scortua/DIIN_PROJECT/README.md

# Proyecto CNC para Cuidado de Plantulas en Vivero

Este proyecto consiste en desarrollar una máquina CNC capaz de cuidar plantulas en un vivero, utilizando motores, materiales reciclables y económicos, incorporando inteligencia artificial y sensores.

## Objetivos
- Automatizar tareas de cuidado en el vivero.
- Optimizar el uso de recursos utilizando materiales reciclables y de bajo costo.
- Integrar sensores para monitorear las condiciones ambientales y de crecimiento de las plantulas.
- Utilizar técnicas de IA para la toma de decisiones en tiempo real.

## Componentes Principales

### Hardware
- **Motores y actuadores:** Responsables del movimiento y la acción precisa en el cuidado de las plantulas.
- **Sensores:** 
    - Sensores de humedad y temperatura para medir las condiciones ambientales.
    - Sensores de luz para asegurar niveles adecuados de iluminación.
- **Materiales reciclables:** Estructuras y componentes fabricados con materiales reutilizados y económicos.
    
### Software
- **Control CNC:** Algoritmos para la operación y movimiento controlado de la máquina.
- **Inteligencia Artificial:** 
    - Procesamiento de datos de sensores.
    - Toma de decisiones automáticas para mejorar el crecimiento de las plantulas.
- **Interfaz de usuario:** Herramienta para monitorear y configurar el sistema en tiempo real.

## Funcionamiento del Sistema

1. **Monitoreo:**  
     Los sensores recogen datos sobre humedad, temperatura y luz.  
2. **Análisis:**  
     La IA analiza la información recopilada para identificar las necesidades de cada plantula.
3. **Acción:**  
     El CNC ejecuta movimientos precisos para crear condiciones óptimas: ajustar la dosificación de agua, mover elementos o modificar la iluminación.
4. **Retroalimentación:**  
     El sistema ajusta sus acciones de forma continua, basándose en los datos en tiempo real.

## Beneficios
- Fomenta el uso de tecnologías sostenibles.
- Aumenta la eficiencia en el cuidado de plantulas.
- Reduce costos mediante el uso de materiales reciclables y componentes económicos.
- Optimiza el crecimiento y la salud de las plantas a través de decisiones basadas en datos.

Este proyecto representa un avance significativo en la integración de la robótica y la inteligencia artificial en la agricultura, proporcionando soluciones innovadoras y sostenibles para el cuidado de viveros.
