scortua/DIIN_PROJECT/Schematic - PCBs/README.md

# Proyecto DIIN
 En este repositorio se encontrara los esquematicos, diseño de PCB's,  programas, etc; sobre el proyecto de CNC que cuide plantulas.
