scortua/DIIN_PROJECT/Images/CNC_DIIN.png

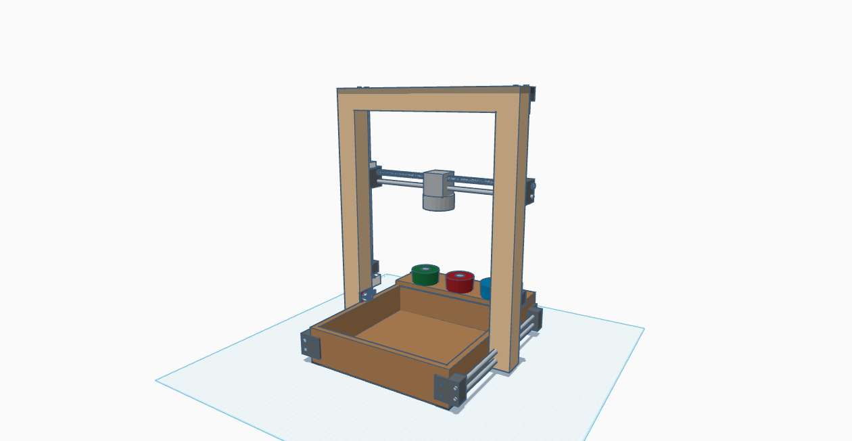
Images/CNC_DIIN.png
