scortua/DIIN_PROJECT/Documents/Box source design/caja_coutois.stl

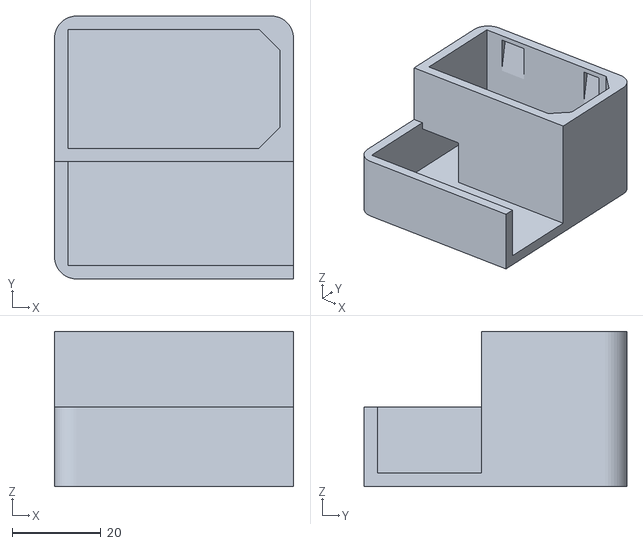
[picture p29: CAD file, 2025-03-30]
Documents/Box source design/caja_coutois.stl
54.0 x 59.3 x 35.0
