scortua/DIIN_PROJECT/(list of files, drawings)

Other design files:
Schematic - PCBs/simulaciones/Project Backups/simulaciones [20250322, 15-41-46].pdsprj
Schematic - PCBs/simulaciones/Project Backups/simulaciones [20250322, 18-07-57].pdsprj
Schematic - PCBs/simulaciones/Project Backups/simulaciones [20250322, 18-07-58].pdsprj
Schematic - PCBs/simulaciones/Project Backups/simulaciones [20250322, 18-08-02].pdsprj
Schematic - PCBs/simulaciones/Project Backups/simulaciones [20250322, 20-23-48].pdsprj
Schematic - PCBs/simulaciones/Project Backups/simulaciones [20250322, 20-23-49].pdsprj
Schematic - PCBs/simulaciones/Project Backups/simulaciones [20250324, 18-50-58].pdsprj
Schematic - PCBs/simulaciones/Project Backups/simulaciones [20250324, 18-50-59].pdsprj
Schematic - PCBs/simulaciones/simulaciones.pdsprj
