scortua/DIIN_PROJECT/Schematic - PCBs/DIIN-proyecto.kicad_pcb

## KiCad design Schematic - PCBs/DIIN-proyecto.kicad_pcb (2025-03-30)

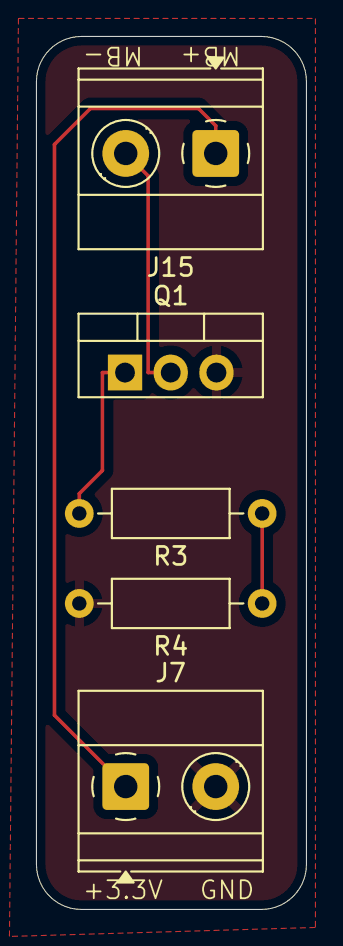
[picture p30: board Schematic - PCBs/DIIN-proyecto.kicad_pcb from above]

Board: 2 copper layers, 15.0 x 48.5 mm, 5 parts (0 on the bottom side), 5 nets.

Parts:
J7, J15: Screw_Terminal_01x02; TerminalBlock_Phoenix_MKDS-1,5-2_1x02_P5.00mm_Horizontal
Q1: IRF540N; TO-220-3_Vertical
R3, R4: 5.1k; R_Axial_DIN0207_L6.3mm_D2.5mm_P10.16mm_Horizontal

Connections:
+3.3V: J7.1, J15.1
GND: J7.2, Q1.3 (S), R4.2
MB-: J15.2, Q1.2 (D)
MBE: R3.1, R4.1
unnamed: Q1.1 (G), R3.2
