scortua/DIIN_PROJECT/Schematic - PCBs/Gerber/camara/camara.kicad_pcb

## KiCad design Schematic - PCBs/Gerber/camara/camara.kicad_pcb (2025-03-30)

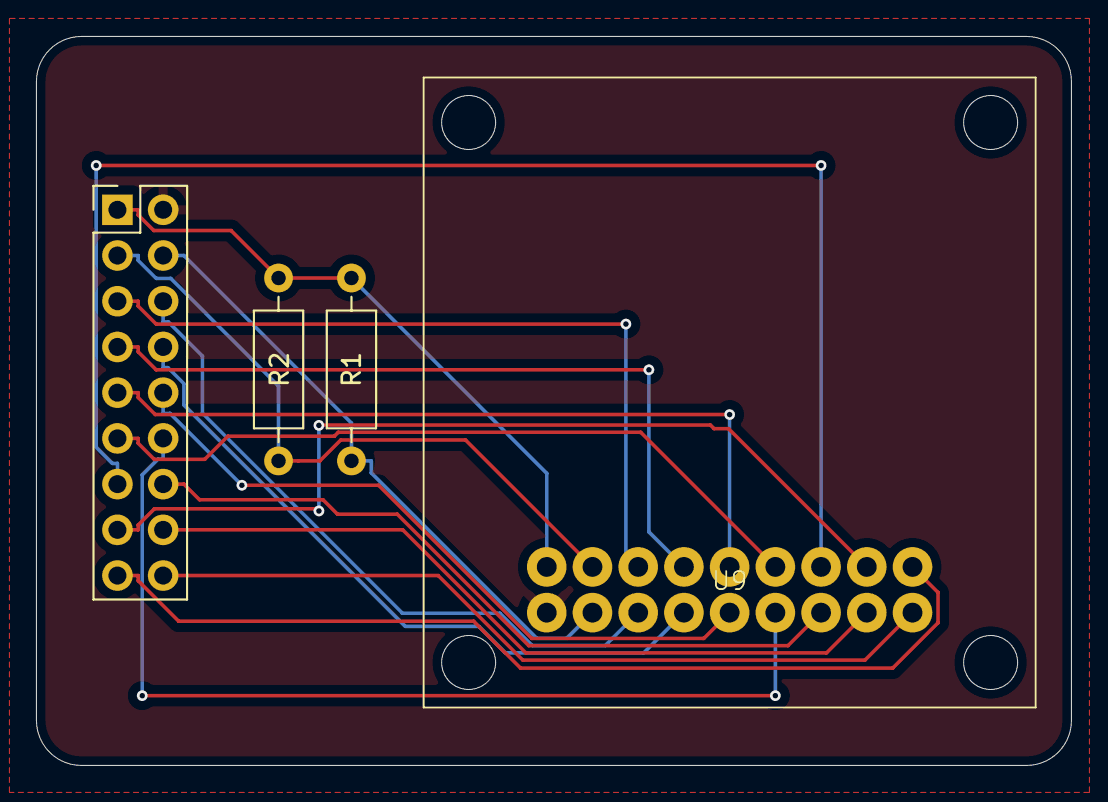
[picture p31: board camara.kicad_pcb from above]

Board: 2 copper layers, 57.5 x 40.5 mm, 4 parts (0 on the bottom side), 18 nets.

Parts:
J1: Conn_02x09_Odd_Even; PinHeader_2x09_P2.54mm_Vertical
R1, R2: 4.7k; R_Axial_DIN0207_L6.3mm_D2.5mm_P10.16mm_Horizontal
U9: OV7670

Connections:
+3.3V: J1.1, R1.1, R2.1, U9.1 (+3.3V)
D0: J1.16, U9.16 (D0)
D1: J1.15, U9.15 (D1)
D2: J1.14, U9.14 (D2)
D3: J1.13, U9.13 (D3)
D4: J1.12, U9.12 (D4)
D5: J1.11, U9.11 (D5)
D6: J1.10, U9.10 (D6)
D7: J1.9, U9.9 (D7)
GND: J1.2, U9.2 (GND)
HREF: J1.6, U9.6 (HREF)
PCLK: J1.7, U9.7 (PCLK)
PWDN: J1.18, U9.18 (PWDN)
RESET: J1.17, U9.17 (RESET)
SOIC: J1.3, R2.2, U9.3 (SOIC)
SOID: J1.4, R1.2, U9.4 (SOID)
VSYNC: J1.5, U9.5 (VSYNC)
XCLK: J1.8, U9.8 (XCLK)
