scortua/DIIN_PROJECT/Schematic - PCBs/Gerber/micros/micros.kicad_pcb

## KiCad design Schematic - PCBs/Gerber/micros/micros.kicad_pcb (2025-03-30)

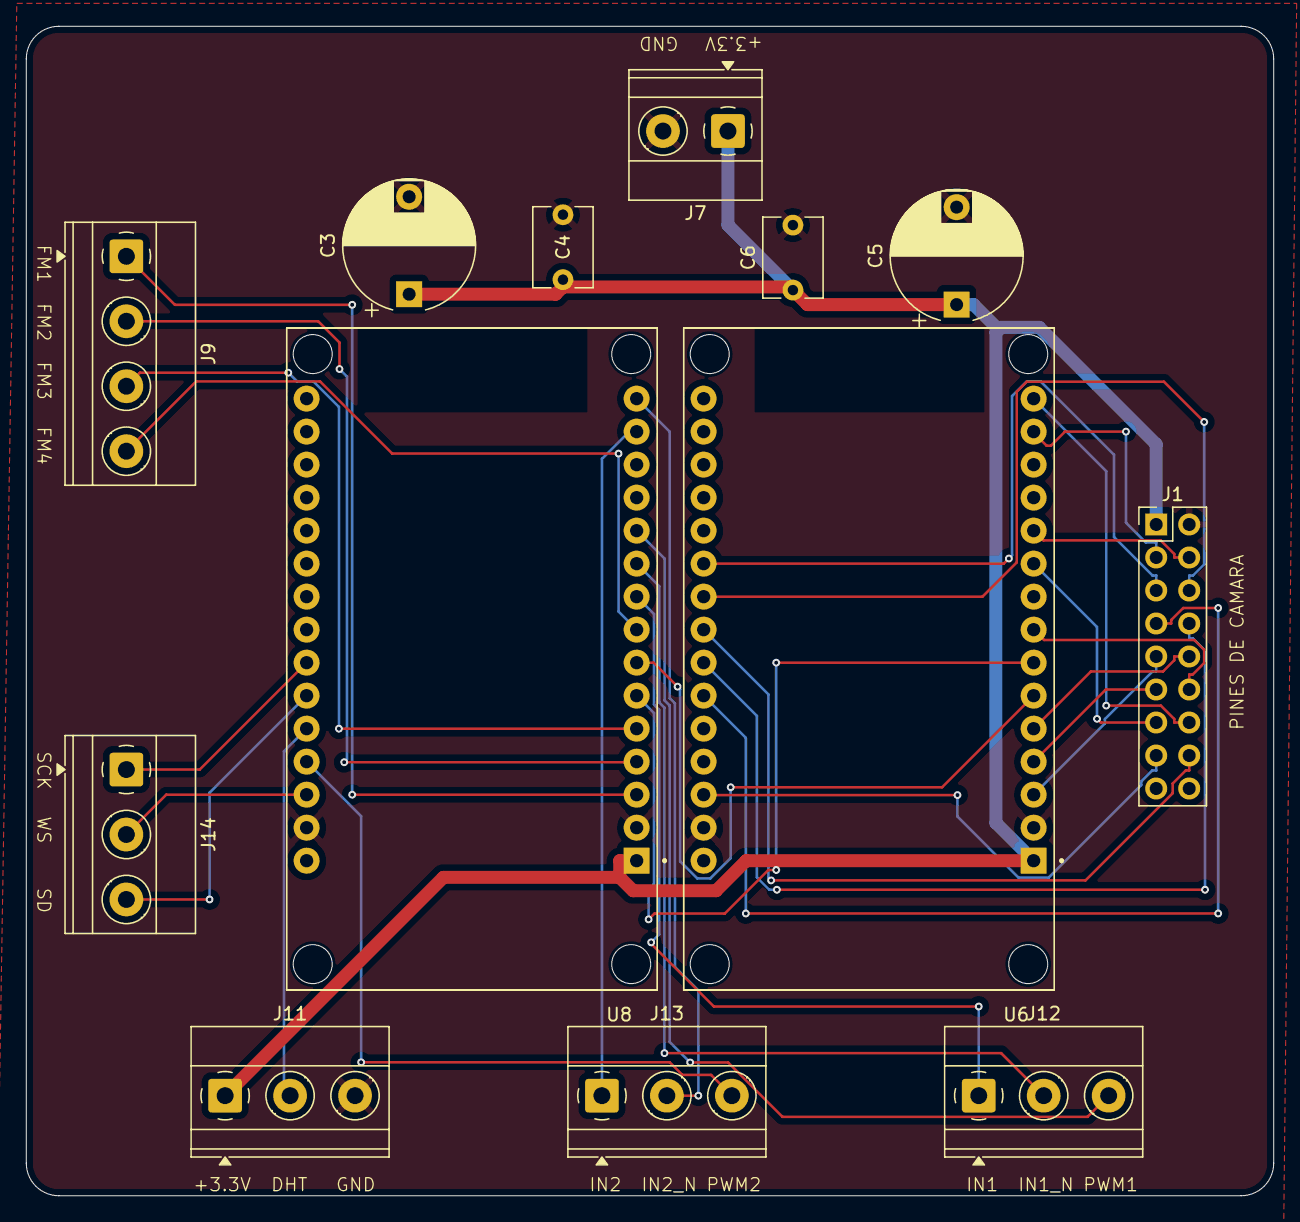
[picture p32: board micros.kicad_pcb from above]

Board: 2 copper layers, 96.0 x 90.0 mm, 13 parts (0 on the bottom side), 32 nets.

Parts:
C3, C5: 10u; CP_Radial_D10.0mm_P7.50mm
C4, C6: 18n; C_Disc_D6.0mm_W4.4mm_P5.00mm
J1: Conn_02x09_Odd_Even; PinHeader_2x09_P2.54mm_Vertical
J7: Screw_Terminal_01x02; TerminalBlock_Phoenix_MKDS-1,5-2_1x02_P5.00mm_Horizontal
J9: Screw_Terminal_01x04; TerminalBlock_Phoenix_MKDS-1,5-4_1x04_P5.00mm_Horizontal
J11, J12, J13, J14: Screw_Terminal_01x03; TerminalBlock_Phoenix_MKDS-1,5-3_1x03_P5.00mm_Horizontal
U6, U8: ESP32-DEVKIT-V1; MODULE_ESP32_DEVKIT_V1

Connections:
+3.3V: C3.1, C4.1, C5.1, C6.1, J1.1, J7.1, J11.1, U6.1 (3V3), U8.1 (3V3)
D0: J1.16, U6.23 (D25)
D1: J1.15, U6.28 (D13)
D2: J1.14, U6.15 (D23)
D3: J1.13, U6.10 (D19)
D4: J1.12, U6.8 (D5)
D5: J1.11, U6.4 (D2)
D6: J1.10, U6.5 (D4)
D7: J1.9, U6.3 (D15)
DHT: J11.2, U8.26 (D14)
FM1: J9.1, U8.3 (D15)
FM2: J9.2, U8.4 (D2)
FM3: J9.3, U8.5 (D4)
FM4: J9.4, U8.8 (D5)
GND: C3.2, C4.2, C5.2, C6.2, J1.2, J7.2, J11.3, U6.2 (GND), U6.29 (GND), U8.2 (GND), U8.29 (GND)
HREF: J1.6, U6.22 (D33)
IN1: J12.1, U8.9 (D18)
IN1_N: J12.2, U8.10 (D19)
IN2: J13.1, U8.14 (D22)
IN2_N: J13.2, U8.15 (D23)
PCLK: J1.7, U6.25 (D27)
PWM1: J12.3, U8.11 (D21)
PWM2: J13.3, U8.27 (D12)
RX: U6.6 (RX2), U8.7 (TX2)
SCK: J14.1, U8.24 (D26)
SD: J14.3, U8.25 (D27)
SOIC: J1.3, U6.14 (D22)
SOID: J1.4, U6.11 (D21)
TX: U6.7 (TX2), U8.6 (RX2)
VSYNC: J1.5, U6.21 (D32)
WS: J14.2, U8.28 (D13)
XCLK: J1.8, U6.24 (D26)
