scortua/DIIN_PROJECT/Schematic - PCBs/Gerber/motores/DIIN-proyecto.kicad_pcb

## KiCad design Schematic - PCBs/Gerber/motores/DIIN-proyecto.kicad_pcb (2025-03-30)

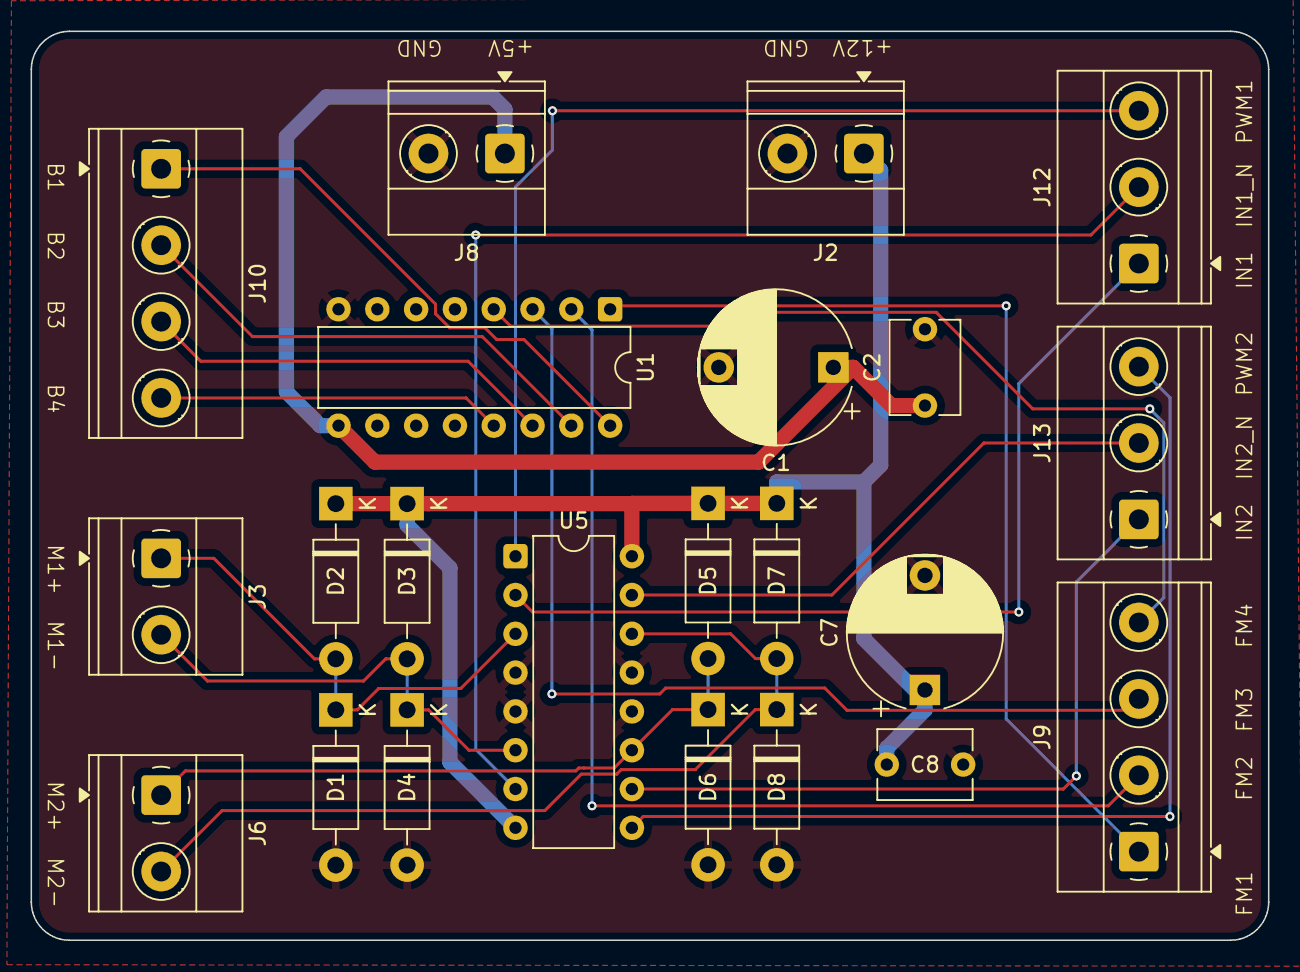
[picture p33: board Schematic - PCBs/Gerber/motores/DIIN-proyecto.kicad_pcb from above]

Board: 2 copper layers, 81.0 x 59.5 mm, 22 parts (0 on the bottom side), 21 nets.

Parts:
C1, C7: 10u; CP_Radial_D10.0mm_P7.50mm
C2, C8: 18n; C_Disc_D6.0mm_W4.4mm_P5.00mm
D1, D2, D3, D4, D5, D6, D7, D8: 1N4004; D_DO-41_SOD81_P10.16mm_Horizontal
J2, J3, J6, J8: Screw_Terminal_01x02; TerminalBlock_Phoenix_MKDS-1,5-2_1x02_P5.00mm_Horizontal
J9, J10: Screw_Terminal_01x04; TerminalBlock_Phoenix_MKDS-1,5-4_1x04_P5.00mm_Horizontal
J12, J13: Screw_Terminal_01x03; TerminalBlock_Phoenix_MKDS-1,5-3_1x03_P5.00mm_Horizontal
U1: ULN2003A; DIP-16_W7.62mm
U5: L293D; DIP-16_W7.62mm

Connections:
+12V: C7.1, C8.1, D2.1 (K), D3.1 (K), D5.1 (K), D7.1 (K), J2.1, U5.8 (VCC2), U5.16 (VCC1)
B1: J10.1, U1.16 (O1)
B2: J10.2, U1.15 (O2)
B3: J10.3, U1.14 (O3)
B4: J10.4, U1.13 (O4)
COM: C1.1, C2.1, J8.1, U1.9 (COM)
FM1: J9.1, U1.1 (I1)
FM2: J9.2, U1.2 (I2)
FM3: J9.3, U1.3 (I3)
FM4: J9.4, U1.4 (I4)
GND: C1.2, C2.2, C7.2, C8.2, D1.2 (A), D4.2 (A), D6.2 (A), D8.2 (A), J2.2, J8.2, U1.8 (GND), U5.4 (GND), U5.5 (GND), U5.12 (GND), U5.13 (GND)
IN1: J12.1, U5.2 (1A)
IN1_N: J12.2, U5.7 (2A)
IN2: J13.1, U5.10 (3A)
IN2_N: J13.2, U5.15 (4A)
PWM1: J12.3, U5.1 (EN1,2)
PWM2: J13.3, U5.9 (EN3,4)
X1: D1.1 (K), D2.2 (A), J3.1, U5.3 (1Y)
X2: D3.2 (A), D4.1 (K), J3.2, U5.6 (2Y)
Y1: D5.2 (A), D6.1 (K), J6.1, U5.11 (3Y)
Y2: D7.2 (A), D8.1 (K), J6.2, U5.14 (4Y)
