scortua/DIIN_PROJECT/Schematic - PCBs/Gerber/fuente/fuente.kicad_pcb

## KiCad design Schematic - PCBs/Gerber/fuente/fuente.kicad_pcb (2025-03-30)

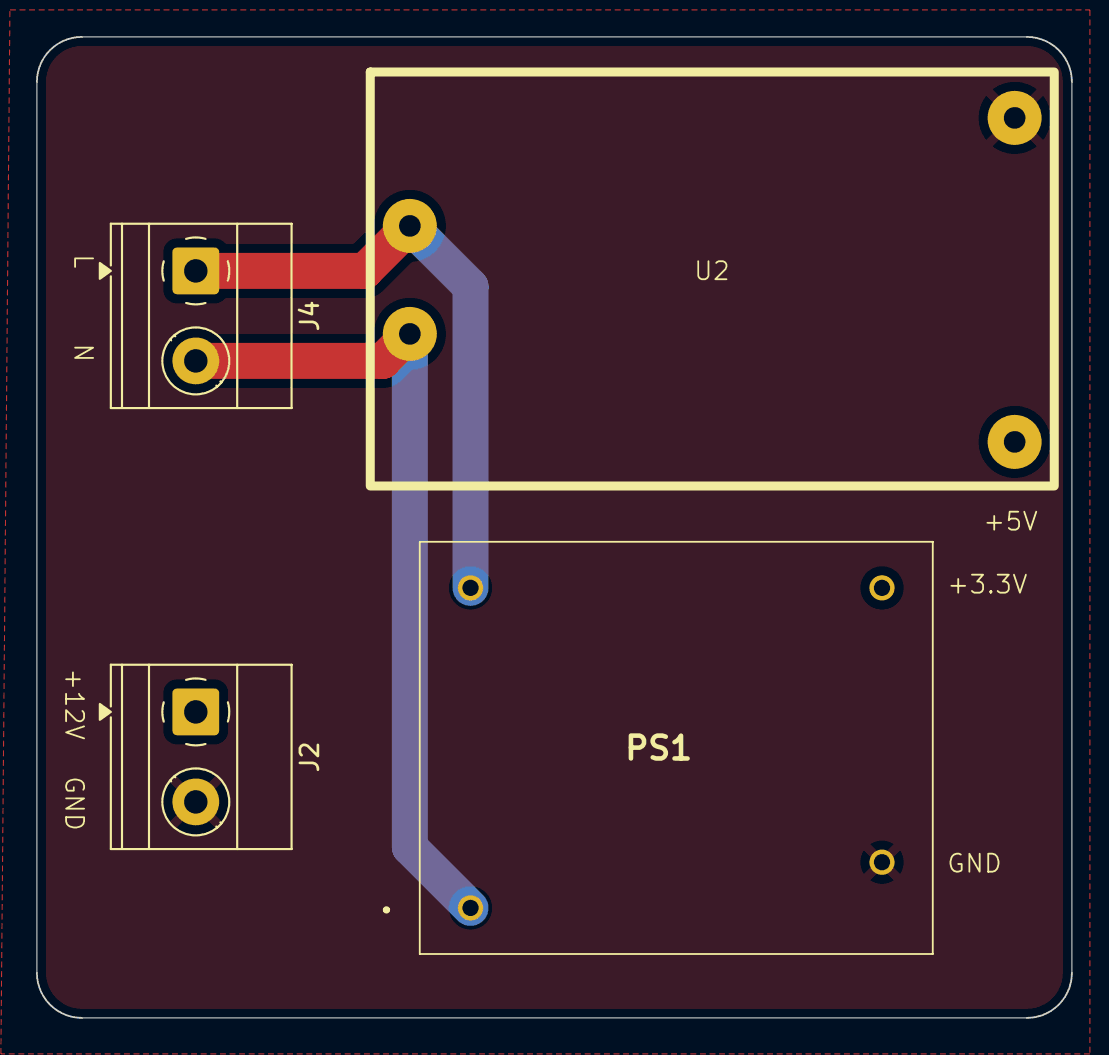
[picture p34: board fuente.kicad_pcb from above]

Board: 2 copper layers, 57.5 x 54.5 mm, 4 parts (0 on the bottom side), 3 nets.

Parts:
J2, J4: Screw_Terminal_01x02; TerminalBlock_Phoenix_MKDS-1,5-2_1x02_P5.00mm_Horizontal
PS1: RAC03-3.3SK; RAC0305SK
U2: HLK-5M03; HLK5M03

Connections:
GND: J2.2, PS1.2 (-VOUT), U2.3 (GND)
L: J4.1, PS1.4 (VAC_IN_(N)), U2.1 (L)
N: J4.2, PS1.1 (VAC_IN_(L)), U2.2 (N)
