scortua/DIIN_PROJECT/Schematic - PCBs/Gerber/microfono/microfono.kicad_pcb

## KiCad design Schematic - PCBs/Gerber/microfono/microfono.kicad_pcb (2025-03-30)

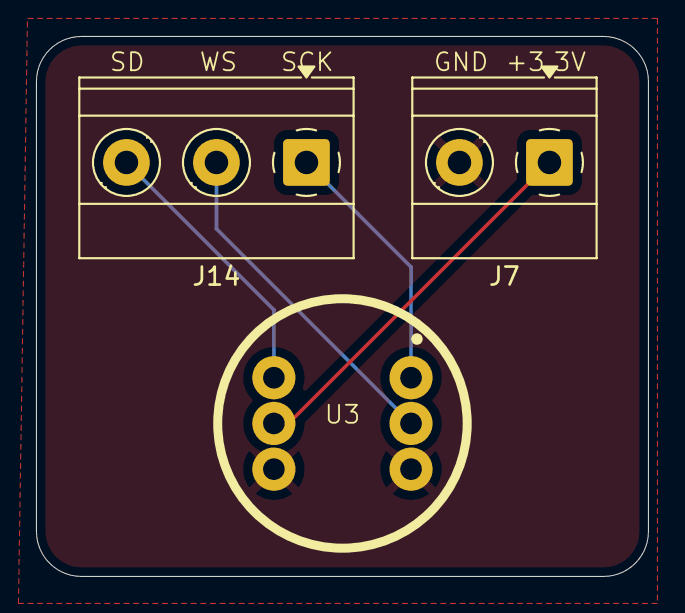
[picture p35: board microfono.kicad_pcb from above]

Board: 2 copper layers, 34.0 x 30.0 mm, 3 parts (0 on the bottom side), 5 nets.

Parts:
J7: Screw_Terminal_01x02; TerminalBlock_Phoenix_MKDS-1,5-2_1x02_P5.00mm_Horizontal
J14: Screw_Terminal_01x03; TerminalBlock_Phoenix_MKDS-1,5-3_1x03_P5.00mm_Horizontal
U3: INMP441

Connections:
+3.3V: J7.1, U3.5 (VDD)
GND: J7.2, U3.3 (L/R), U3.6 (GND)
SCK: J14.1, U3.1 (SCK)
SD: J14.3, U3.4 (SD)
WS: J14.2, U3.2 (WS)
