scortua/DIIN_PROJECT/Code/ESP32_I2S_Camera/ESP32_I2S_Camera_git/XClk.cpp

//parts of his code are taken from
//https://github.com/igrr/esp32-cam-demo
//by Ivan Grokhotkov
//released under Apache License 2.0

//Creación de timer para comunicación I2S

#include "XClk.h"
#include "driver/ledc.h"
#include "Log.h"

bool ClockEnable(int pin, int Hz) {
    periph_module_enable(PERIPH_LEDC_MODULE);

    DEBUG_PRINT("XCLK Frequency Requested: ");
    DEBUG_PRINTLN(Hz);

    ledc_timer_config_t timer_conf;
    timer_conf.bit_num = (ledc_timer_bit_t)1;
    timer_conf.freq_hz = Hz;
    timer_conf.speed_mode = LEDC_HIGH_SPEED_MODE;
    timer_conf.timer_num = LEDC_TIMER_0;
    timer_conf.clk_cfg = LEDC_AUTO_CLK;
    esp_err_t err = ledc_timer_config(&timer_conf);
    if (err != ESP_OK) {
        DEBUG_PRINT("ledc_timer_config error: ");
        DEBUG_PRINTLN(err);
        return false;
    }

    ledc_channel_config_t ch_conf;
    ch_conf.channel = LEDC_CHANNEL_0;
    ch_conf.timer_sel = LEDC_TIMER_0;
    ch_conf.intr_type = LEDC_INTR_DISABLE;
    ch_conf.duty = 1;
    ch_conf.speed_mode = LEDC_HIGH_SPEED_MODE;
    ch_conf.gpio_num = pin;

    ch_conf.hpoint = 0; //added by me

    err = ledc_channel_config(&ch_conf);
    if (err != ESP_OK) {
        DEBUG_PRINT("ledc_channel_config error: ");
        DEBUG_PRINTLN(err);
        return false;
    }
    return true;
}

void ClockDisable() {
    periph_module_disable(PERIPH_LEDC_MODULE);
}
