scortua/DIIN_PROJECT/(commit log)

2025-03-30 ADD modelos detallados y funcionales
    [DIIN-proyecto-B_Cu.gbr, DIIN-proyecto-B_Mask.gbr, DIIN-proyecto-B_Paste.gbr, DIIN-proyecto-B_Silkscreen.gbr, DIIN-proyecto-Edge_Cuts.gbr, DIIN-proyecto-F_Cu.gbr, DIIN-proyecto-F_Mask.gbr, DIIN-proyecto-F_Paste.gbr]
2025-04-12 ADD implementaciones de actuadores
2025-04-21 ADD codigo probar motores
2025-04-24 UPDATE codigo de prueba web y uso de micro
2025-05-01 UPDATE base para poder usar botones y motores
2025-05-02 UPDATE usar motores y visualizacion web
